EthernetWizard/pen-esp32s3-case/stl/pen_bottom.stl

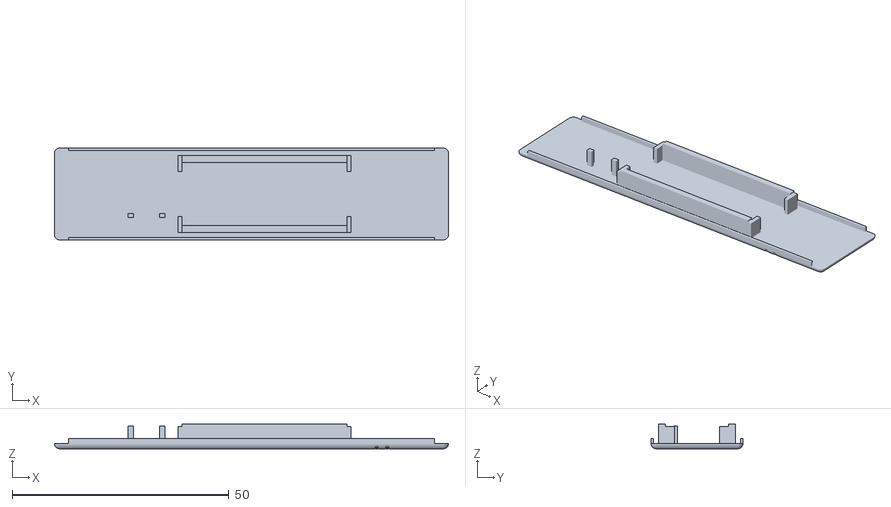
[picture p4: CAD file, 2026-10-30]
stl/pen_bottom.stl
90.9 x 21.2 x 5.70
