EthernetWizard/pen-esp32s3-case/stl/pen_top.stl

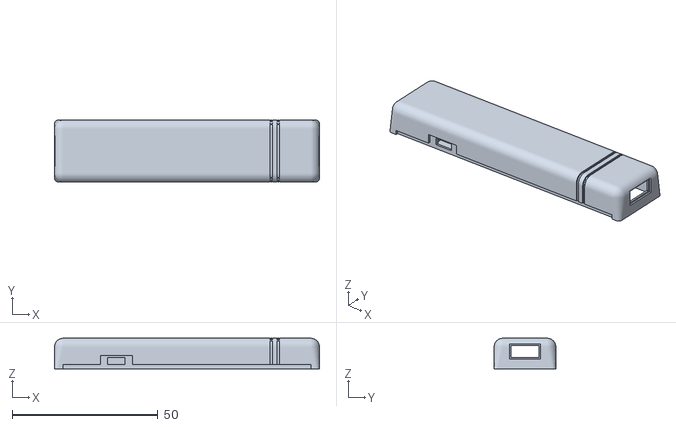
[picture p5: CAD file, 2026-10-30]
stl/pen_top.stl
90.9 x 21.2 x 10.5
